vladmacuc/Stabilizator-de-tensiune-cu-tensiunea-de-iesire-reglabila/Proiect CAD final/STABILIZATORDETENSIUNE_2.png

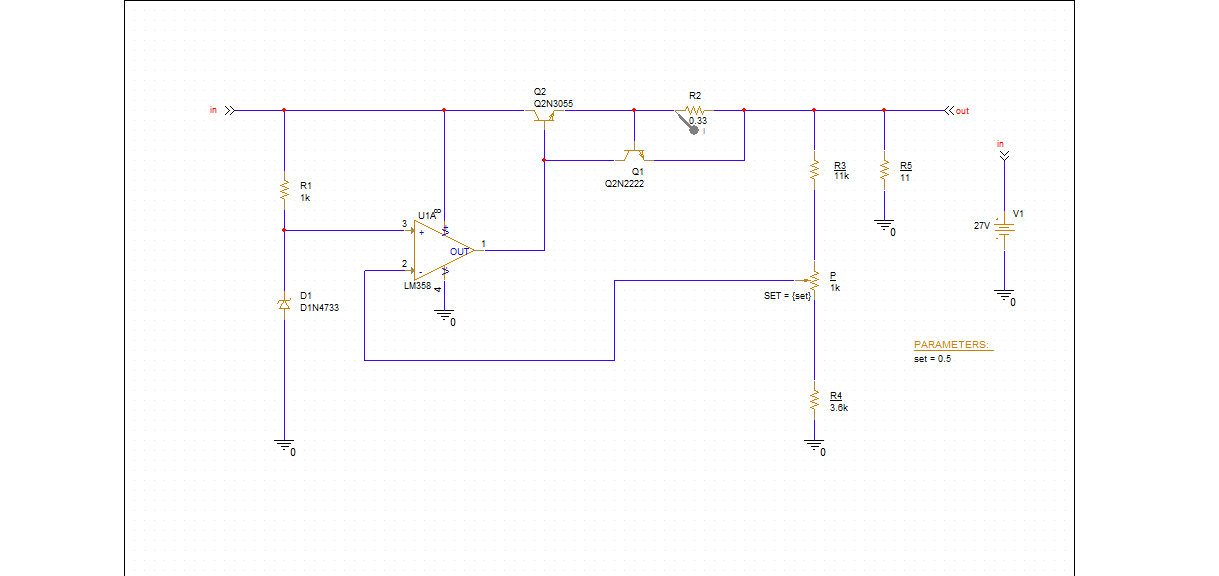
Proiect CAD final/STABILIZATORDETENSIUNE_2.png
