vladmacuc/Stabilizator-de-tensiune-cu-tensiunea-de-iesire-reglabila/(list of files, drawings)

Other design files:
Proiect CAD final/STABILIZATORDETENSIUNE_2.DSN
Proiect CAD final/StabilizatorDeTensiune_2.opj
